MinhuanGuo/MPU9250-AHRS-Arduino/[01]_Arduino_Code_MPU9250/Readme.txt

本程序功能：

1. 读取MPU9250模块9个数据：三轴陀螺，三轴加表，三轴磁；
2. 将读到的9个数据打包，编码
3. 串口发送
