MinhuanGuo/MPU9250-AHRS-Arduino/[02]_C#_IMU_Exe/Form_3Dcuboid/Right.png

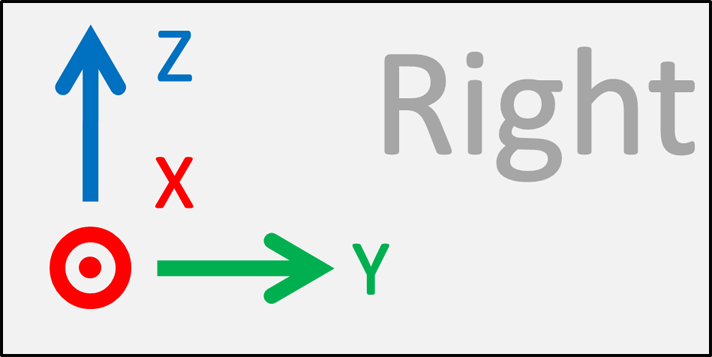
[02]_C#_IMU_Exe/Form_3Dcuboid/Right.png
