MinhuanGuo/MPU9250-AHRS-Arduino/[02]_C#_IMU_Exe/Form_3Dcuboid/RightInv.png

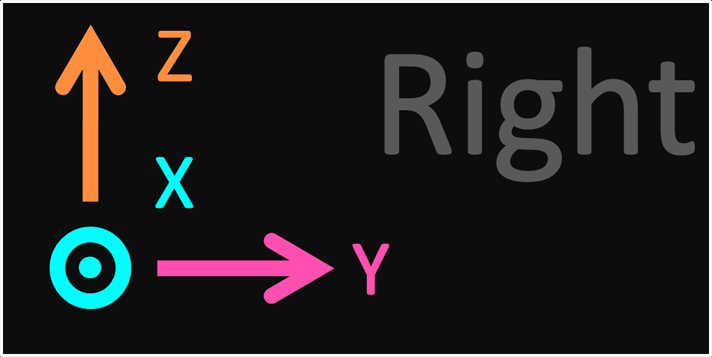
[02]_C#_IMU_Exe/Form_3Dcuboid/RightInv.png
